skagon/HelioMax/FFCs/HelioMax.kicad_pcb

## KiCad design FFCs/HelioMax.kicad_pcb (2026-10-24)

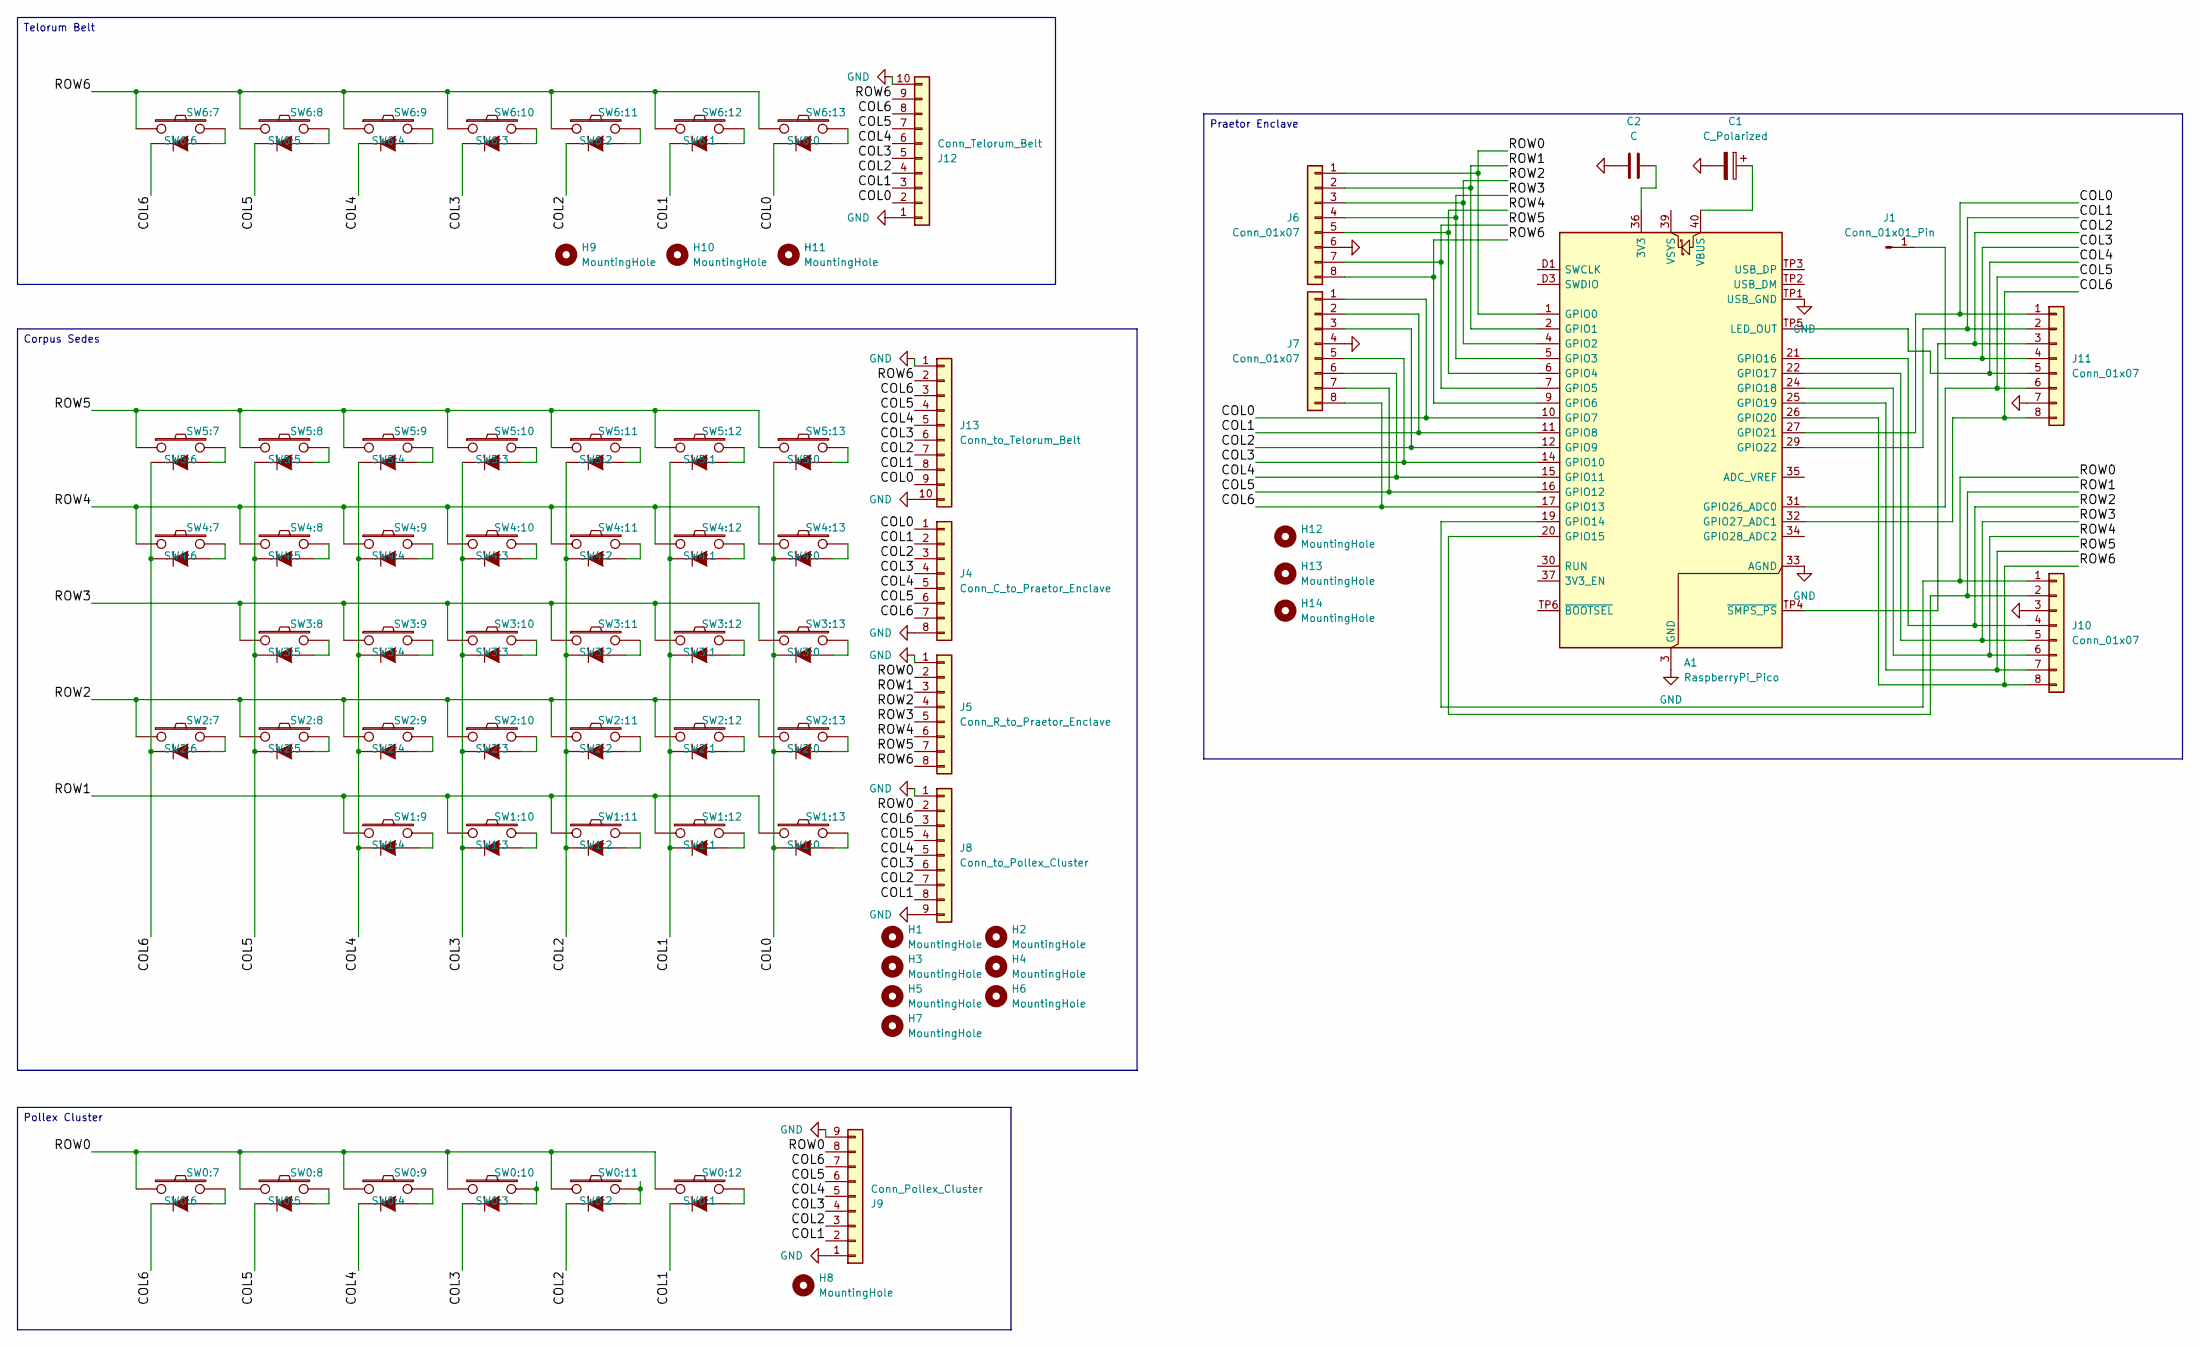
[picture p1: schematic HelioMax.kicad_sch]

Parts:
A1: RaspberryPi_Pico; RaspberryPi_Pico_Original_SMD_MountingHoles_HandSolder_Cast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
C1: C_Polarized; CP_Radial_D4.0mm_P2.00mm
C2: C; C_Rect_L7.0mm_W2.5mm_P5.00mm
H1, H2, H3, H4, H5, H6, H7, H8, H9, H10, H11, H12, H13, H14: MountingHole; MountingHole_3.2mm_M3
J1: Conn_01x01_Pin; PinHeader_1x01_P1.00mm_Vertical
J4: Conn_C_to_Praetor_Enclave; JST_SH_SM08B-SRSS-TB_1x08-1MP_P1.00mm_Horizontal
J5: Conn_R_to_Praetor_Enclave; JST_SH_SM08B-SRSS-TB_1x08-1MP_P1.00mm_Horizontal
J6, J7, J10, J11: Conn_01x07; JST_SH_SM08B-SRSS-TB_1x08-1MP_P1.00mm_Horizontal
J8: Conn_to_Pollex_Cluster; Molex_200528-0090_1x09-1MP_P1.00mm_Horizontal
J9: Conn_Pollex_Cluster; Molex_200528-0090_1x09-1MP_P1.00mm_Horizontal
J12: Conn_Telorum_Belt; Molex_200528-0100_1x10-1MP_P1.00mm_Horizontal
J13: Conn_to_Telorum_Belt; Molex_200528-0100_1x10-1MP_P1.00mm_Horizontal
SW0:7: SW0:6; MX_FLIP_CLEAN
SW0:8: SW0:5; MX_FLIP_CLEAN
SW0:9: SW0:4; MX_FLIP_CLEAN
SW0:10: SW0:3; MX_FLIP_CLEAN
SW0:11: SW0:2; MX_FLIP_CLEAN
SW0:12: SW0:1; MX_FLIP_CLEAN
SW1:9: SW1:4; MX_FLIP_CLEAN
SW1:10: SW1:3; MX_FLIP_CLEAN
SW1:11: SW1:2; MX_FLIP_CLEAN
SW1:12: SW1:1; MX_FLIP_CLEAN
SW1:13: SW1:0; MX_FLIP_CLEAN
SW2:7: SW2:6; MX_FLIP_CLEAN
SW2:8: SW2:5; MX_FLIP_CLEAN
SW2:9: SW2:4; MX_FLIP_CLEAN
SW2:10: SW2:3; MX_FLIP_CLEAN
SW2:11: SW2:2; MX_FLIP_CLEAN
SW2:12: SW2:1; MX_FLIP_CLEAN
SW2:13: SW2:0; MX_FLIP_CLEAN
SW3:8: SW3:5; MX_FLIP_CLEAN
SW3:9: SW3:4; MX_FLIP_CLEAN
SW3:10: SW3:3; MX_FLIP_CLEAN
SW3:11: SW3:2; MX_FLIP_CLEAN
SW3:12: SW3:1; MX_FLIP_CLEAN
SW3:13: SW3:0; MX_FLIP_CLEAN
SW4:7: SW4:6; MX_FLIP_CLEAN
SW4:8: SW4:5; MX_FLIP_CLEAN
SW4:9: SW4:4; MX_FLIP_CLEAN
SW4:10: SW4:3; MX_FLIP_CLEAN
SW4:11: SW4:2; MX_FLIP_CLEAN
SW4:12: SW4:1; MX_FLIP_CLEAN
SW4:13: SW4:0; MX_FLIP_CLEAN
SW5:7: SW5:6; MX_FLIP_CLEAN
SW5:8: SW5:5; MX_FLIP_CLEAN
SW5:9: SW5:4; MX_FLIP_CLEAN
SW5:10: SW5:3; MX_FLIP_CLEAN
SW5:11: SW5:2; MX_FLIP_CLEAN
SW5:12: SW5:1; MX_FLIP_CLEAN
SW5:13: SW5:0; MX_FLIP_CLEAN
SW6:7: SW6:6; MX_FLIP_CLEAN
SW6:8: SW6:5; MX_FLIP_CLEAN
SW6:9: SW6:4; MX_FLIP_CLEAN
SW6:10: SW6:3; MX_FLIP_CLEAN
SW6:11: SW6:2; MX_FLIP_CLEAN
SW6:12: SW6:1; MX_FLIP_CLEAN
SW6:13: SW6:0; MX_FLIP_CLEAN

Connections:
/COL0: A1.10 (GPIO7), A1.27 (GPIO21), J4.1, J7.1, J11.1, J12.2, J13.9, SW1:13.4 (K), SW2:13.4 (K), SW3:13.4 (K), SW4:13.4 (K), SW5:13.4 (K), SW6:13.4 (K); also elsewhere on the board
/COL1: A1.11 (GPIO8), A1.29 (GPIO22), J4.2, J7.2, J8.8, J9.2, J11.2, J12.3, J13.8, SW0:12.4 (K), SW1:12.4 (K), SW2:12.4 (K), SW3:12.4 (K), SW4:12.4 (K), SW5:12.4 (K), SW6:12.4 (K); also elsewhere on the board
/COL2: A1.12 (GPIO9), A1.TP4 (~SMPS_PS), J4.3, J7.3, J8.7, J9.3, J11.3, J12.4, J13.7, SW0:11.4 (K), SW1:11.4 (K), SW2:11.4 (K), SW3:11.4 (K), SW4:11.4 (K), SW5:11.4 (K), SW6:11.4 (K); also elsewhere on the board
/COL3: A1.14 (GPIO10), J1.1 (Pin_1_1), J4.4, J7.5, J8.6, J9.4, J11.4, J12.5, J13.6, SW0:10.4 (K), SW1:10.4 (K), SW2:10.4 (K), SW3:10.4 (K), SW4:10.4 (K), SW5:10.4 (K), SW6:10.4 (K); also elsewhere on the board
/COL4: A1.15 (GPIO11), A1.TP5 (LED_OUT), J4.5, J7.6, J8.5, J9.5, J11.5, J12.6, J13.5, SW0:9.4 (K), SW1:9.4 (K), SW2:9.4 (K), SW3:9.4 (K), SW4:9.4 (K), SW5:9.4 (K), SW6:9.4 (K); also elsewhere on the board
/COL5: A1.16 (GPIO12), A1.31 (GPIO26_ADC0), J4.6, J7.7, J8.4, J9.6, J11.6, J12.7, J13.4, SW0:8.4 (K), SW2:8.4 (K), SW3:8.4 (K), SW4:8.4 (K), SW5:8.4 (K), SW6:8.4 (K); also elsewhere on the board
/COL6: A1.17 (GPIO13), A1.32 (GPIO27_ADC1), J4.7, J7.8, J8.3, J9.7, J11.8, J12.8, J13.3, SW0:7.4 (K), SW2:7.4 (K), SW4:7.4 (K), SW5:7.4 (K), SW6:7.4 (K); also elsewhere on the board
/ROW0: A1.1 (GPIO0), A1.19 (GPIO14), J5.2, J6.1, J8.2, J9.8, J10.1, SW0:7.1, SW0:8.1, SW0:9.1, SW0:10.1, SW0:11.1, SW0:12.1; also elsewhere on the board
/ROW1: A1.2 (GPIO1), A1.20 (GPIO15), J5.3, J6.2, J10.2, SW1:9.1, SW1:10.1, SW1:11.1, SW1:12.1, SW1:13.1; also elsewhere on the board
/ROW2: A1.4 (GPIO2), A1.21 (GPIO16), J5.4, J6.3, J10.4, SW2:7.1, SW2:8.1, SW2:9.1, SW2:10.1, SW2:11.1, SW2:12.1, SW2:13.1; also elsewhere on the board
/ROW3: A1.5 (GPIO3), A1.22 (GPIO17), J5.5, J6.4, J10.5, SW3:8.1, SW3:9.1, SW3:10.1, SW3:11.1, SW3:12.1, SW3:13.1; also elsewhere on the board
/ROW4: A1.6 (GPIO4), A1.24 (GPIO18), J5.6, J6.5, J10.6, SW4:7.1, SW4:8.1, SW4:9.1, SW4:10.1, SW4:11.1, SW4:12.1, SW4:13.1; also elsewhere on the board
/ROW5: A1.7 (GPIO5), A1.25 (GPIO19), J5.7, J6.7, J10.7, SW5:7.1, SW5:8.1, SW5:9.1, SW5:10.1, SW5:11.1, SW5:12.1, SW5:13.1; also elsewhere on the board
/ROW6: A1.9 (GPIO6), A1.26 (GPIO20), J5.8, J6.8, J10.8, J12.9, J13.2, SW6:7.1, SW6:8.1, SW6:9.1, SW6:10.1, SW6:11.1, SW6:12.1, SW6:13.1; also elsewhere on the board
GND: A1.3 (GND), A1.8 (GND), A1.13 (GND), A1.18 (GND), A1.23 (GND), A1.28 (GND), A1.33 (AGND), A1.38 (GND), A1.D2 (GND), A1.TP1 (USB_GND), C1.2, C2.2, J4.8, J5.1, J6.6, J6.MP, J7.4, J7.MP, J8.1, J8.9, J8.MP, J9.1, J9.9, J9.MP, J10.3, J10.MP, J11.7, J11.MP, J12.1, J12.10, J12.MP, J13.1, J13.10, J13.MP; also elsewhere on the board
unnamed: A1.36 (3V3), C2.1
unnamed: A1.40 (VBUS), C1.1
unnamed: SW0:7.2, SW0:7.3 (A)
unnamed: SW0:8.2, SW0:8.3 (A)
unnamed: SW0:9.2, SW0:9.3 (A)
unnamed: SW0:10.2, SW0:10.3 (A)
unnamed: SW0:11.2, SW0:11.3 (A)
unnamed: SW0:12.2, SW0:12.3 (A)
unnamed: SW1:9.2, SW1:9.3 (A)
unnamed: SW1:10.2, SW1:10.3 (A)
unnamed: SW1:11.2, SW1:11.3 (A)
unnamed: SW1:12.2, SW1:12.3 (A)
unnamed: SW1:13.2, SW1:13.3 (A)
unnamed: SW2:7.2, SW2:7.3 (A)
unnamed: SW2:8.2, SW2:8.3 (A)
unnamed: SW2:9.2, SW2:9.3 (A)
unnamed: SW2:10.2, SW2:10.3 (A)
unnamed: SW2:11.2, SW2:11.3 (A)
unnamed: SW2:12.2, SW2:12.3 (A)
unnamed: SW2:13.2, SW2:13.3 (A)
unnamed: SW3:8.2, SW3:8.3 (A)
unnamed: SW3:9.2, SW3:9.3 (A)
unnamed: SW3:10.2, SW3:10.3 (A)
unnamed: SW3:11.2, SW3:11.3 (A)
unnamed: SW3:12.2, SW3:12.3 (A)
unnamed: SW3:13.2, SW3:13.3 (A)
unnamed: SW4:7.2, SW4:7.3 (A)
unnamed: SW4:8.2, SW4:8.3 (A)
unnamed: SW4:9.2, SW4:9.3 (A)
unnamed: SW4:10.2, SW4:10.3 (A)
unnamed: SW4:11.2, SW4:11.3 (A)
unnamed: SW4:12.2, SW4:12.3 (A)
unnamed: SW4:13.2, SW4:13.3 (A)
unnamed: SW5:7.2, SW5:7.3 (A)
unnamed: SW5:8.2, SW5:8.3 (A)
unnamed: SW5:9.2, SW5:9.3 (A)
unnamed: SW5:10.2, SW5:10.3 (A)
unnamed: SW5:11.2, SW5:11.3 (A)
unnamed: SW5:12.2, SW5:12.3 (A)
unnamed: SW5:13.2, SW5:13.3 (A)
unnamed: SW6:7.2, SW6:7.3 (A)
unnamed: SW6:8.2, SW6:8.3 (A)
unnamed: SW6:9.2, SW6:9.3 (A)
unnamed: SW6:10.2, SW6:10.3 (A)
unnamed: SW6:11.2, SW6:11.3 (A)
unnamed: SW6:12.2, SW6:12.3 (A)
unnamed: SW6:13.2, SW6:13.3 (A)

Notes on the sheet:
Telorum Belt
Pollex Cluster
Praetor Enclave
Corpus Sedes

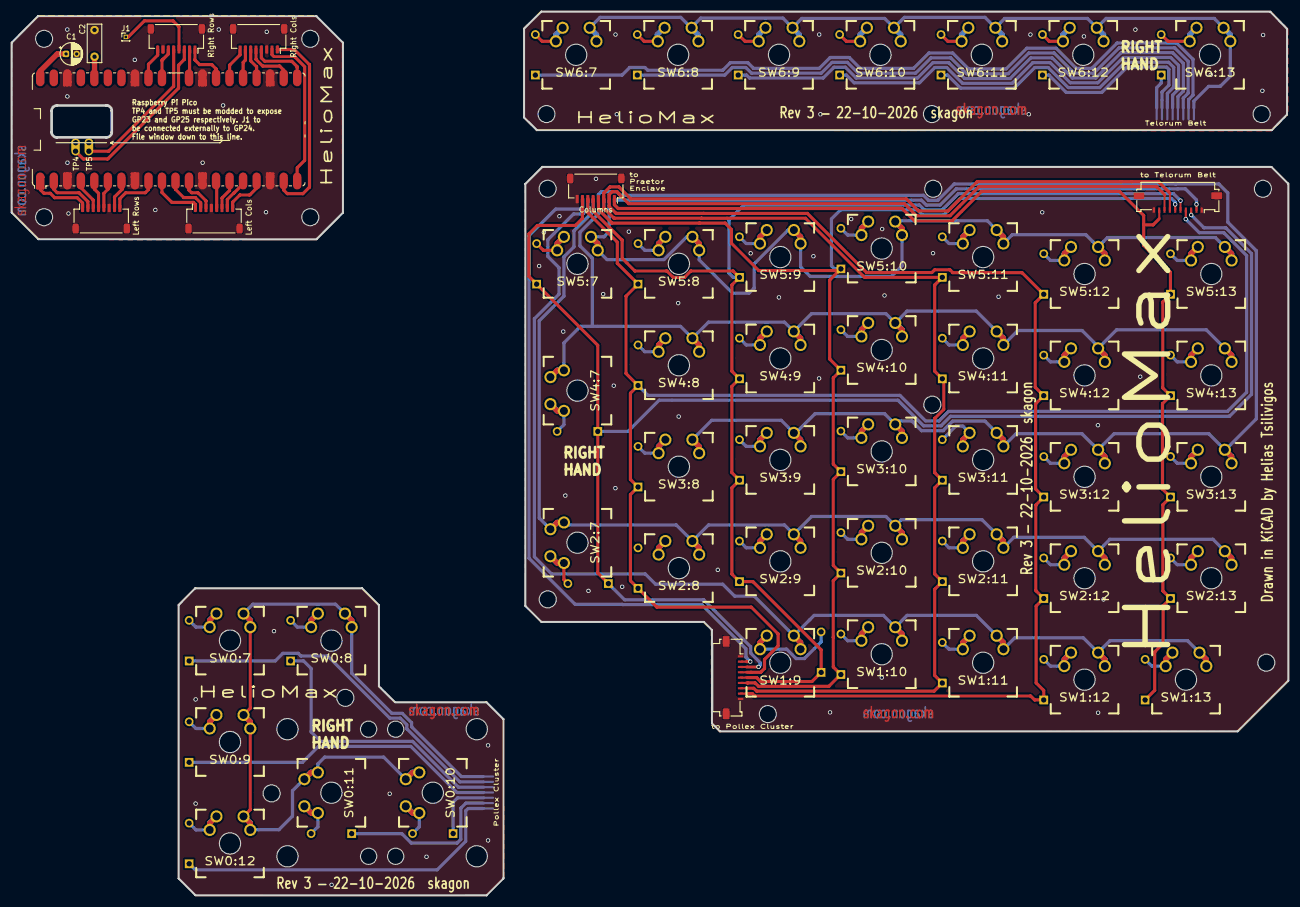
[picture p2: board HelioMax.kicad_pcb from above]

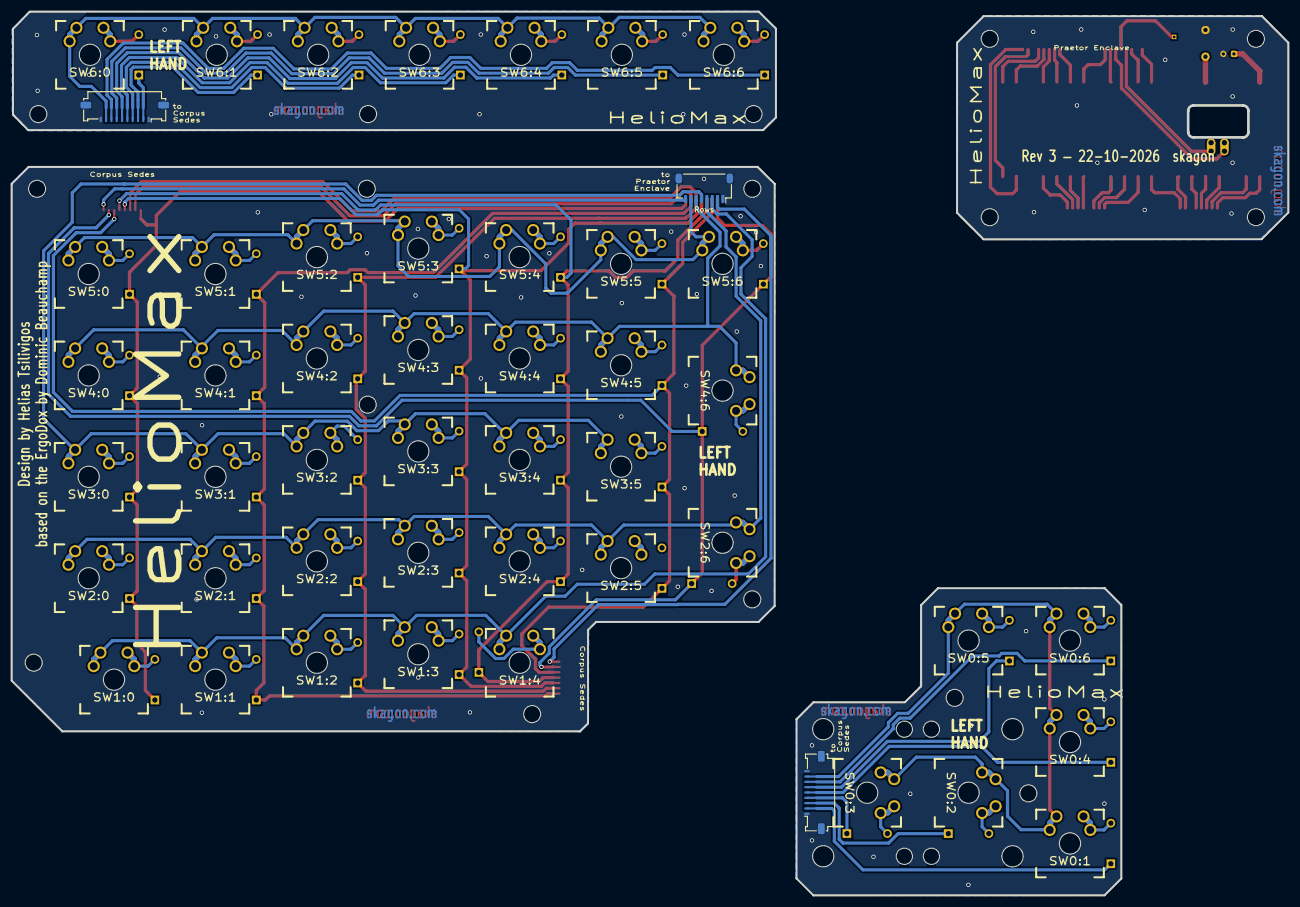
[picture p3: board HelioMax.kicad_pcb from below]

Board: 2 copper layers, 239.8 x 166.0 mm, 75 parts (3 on the bottom side), 62 nets.

Other parts of the board:
Columns: Conn_C_to_Praetor_Enclave; JST_SH_SM08B-SRSS-TB_1x08-1MP_P1.00mm_Horizontal
Rows: Conn_R_to_Praetor_Enclave; JST_SH_SM08B-SRSS-TB_1x08-1MP_P1.00mm_Horizontal
S1, S2: STAB200; STAB_PCB940

Their connections:
/COL0: Columns.1; also elsewhere on the board
/COL1: Columns.2; also elsewhere on the board
/COL2: Columns.3; also elsewhere on the board
/COL3: Columns.4; also elsewhere on the board
/COL4: Columns.5; also elsewhere on the board
/COL5: Columns.6; also elsewhere on the board
/COL6: Columns.7; also elsewhere on the board
/ROW0: Rows.2; also elsewhere on the board
/ROW1: Rows.3; also elsewhere on the board
/ROW2: Rows.4; also elsewhere on the board
/ROW3: Rows.5; also elsewhere on the board
/ROW4: Rows.6; also elsewhere on the board
/ROW5: Rows.7; also elsewhere on the board
/ROW6: Rows.8; also elsewhere on the board
GND: Columns.8, Columns.MP, Rows.1, Rows.MP; also elsewhere on the board
