skagon/HelioMax/FFCs/Corpus_Sedes/HelioMax_Corpus_Sedes.kicad_sch

## KiCad design FFCs/Corpus_Sedes/HelioMax_Corpus_Sedes.kicad_sch (2026-10-18)

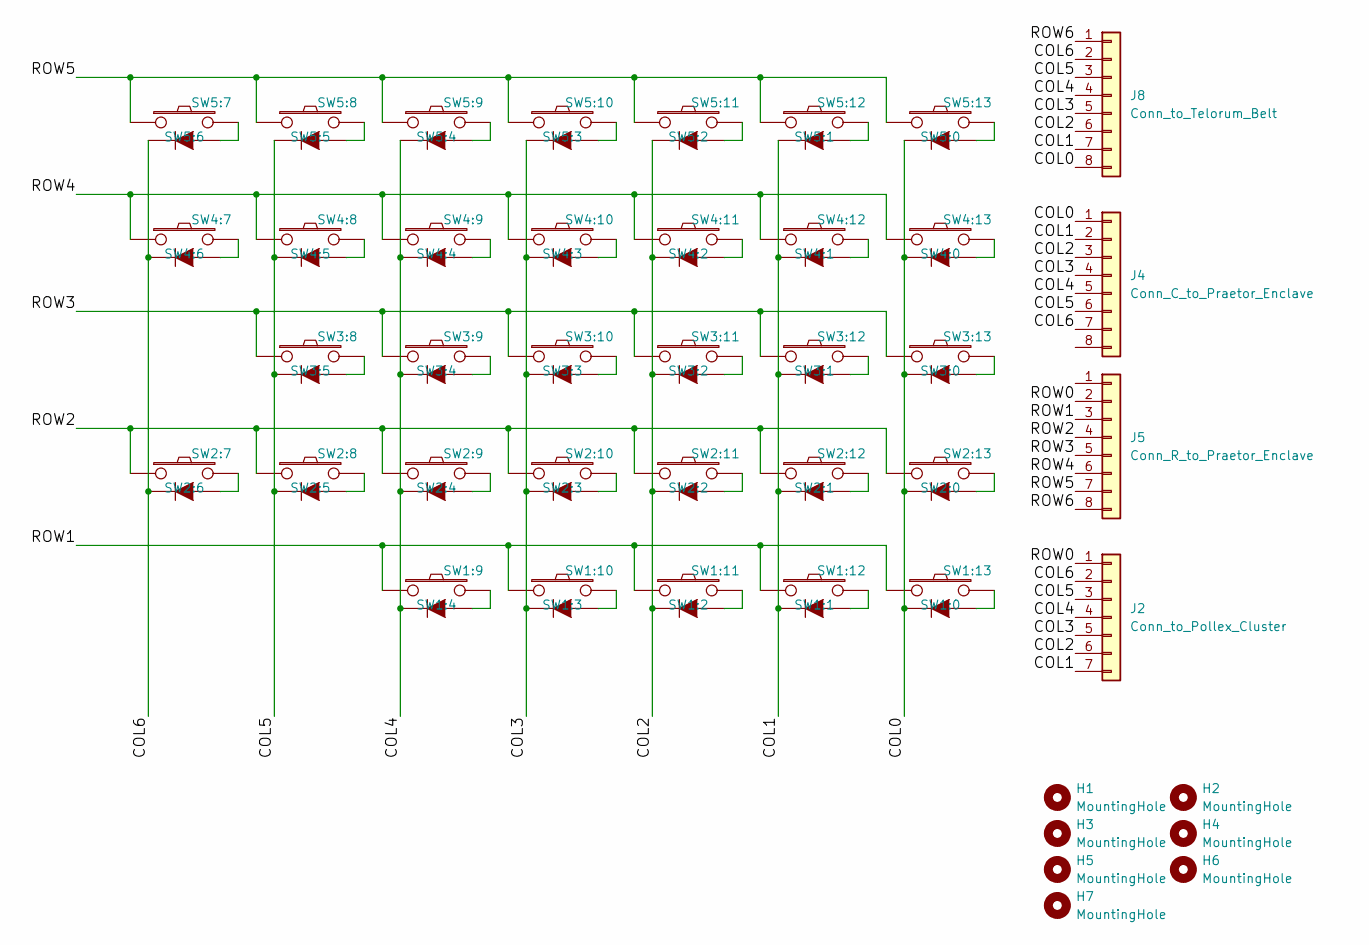
[picture p7: schematic HelioMax_Corpus_Sedes.kicad_sch]

Parts:
H1, H2, H3, H4, H5, H6, H7: MountingHole; MountingHole_3.2mm_M3
J2: Conn_to_Pollex_Cluster; PinHeader_1x07_P2.54mm_Vertical
J4: Conn_C_to_Praetor_Enclave; JST_SH_SM08B-SRSS-TB_1x08-1MP_P1.00mm_Horizontal
J5: Conn_R_to_Praetor_Enclave; JST_SH_SM08B-SRSS-TB_1x08-1MP_P1.00mm_Horizontal
J8: Conn_to_Telorum_Belt; PinHeader_1x08_P2.54mm_Vertical
SW1:9: SW1:4; MX_FLIP_CLEAN
SW1:10: SW1:3; MX_FLIP_CLEAN
SW1:11: SW1:2; MX_FLIP_CLEAN
SW1:12: SW1:1; MX_FLIP_CLEAN
SW1:13: SW1:0; MX_FLIP_CLEAN
SW2:7: SW2:6; MX_FLIP_CLEAN
SW2:8: SW2:5; MX_FLIP_CLEAN
SW2:9: SW2:4; MX_FLIP_CLEAN
SW2:10: SW2:3; MX_FLIP_CLEAN
SW2:11: SW2:2; MX_FLIP_CLEAN
SW2:12: SW2:1; MX_FLIP_CLEAN
SW2:13: SW2:0; MX_FLIP_CLEAN
SW3:8: SW3:5; MX_FLIP_CLEAN
SW3:9: SW3:4; MX_FLIP_CLEAN
SW3:10: SW3:3; MX_FLIP_CLEAN
SW3:11: SW3:2; MX_FLIP_CLEAN
SW3:12: SW3:1; MX_FLIP_CLEAN
SW3:13: SW3:0; MX_FLIP_CLEAN
SW4:7: SW4:6; MX_FLIP_CLEAN
SW4:8: SW4:5; MX_FLIP_CLEAN
SW4:9: SW4:4; MX_FLIP_CLEAN
SW4:10: SW4:3; MX_FLIP_CLEAN
SW4:11: SW4:2; MX_FLIP_CLEAN
SW4:12: SW4:1; MX_FLIP_CLEAN
SW4:13: SW4:0; MX_FLIP_CLEAN
SW5:7: SW5:6; MX_FLIP_CLEAN
SW5:8: SW5:5; MX_FLIP_CLEAN
SW5:9: SW5:4; MX_FLIP_CLEAN
SW5:10: SW5:3; MX_FLIP_CLEAN
SW5:11: SW5:2; MX_FLIP_CLEAN
SW5:12: SW5:1; MX_FLIP_CLEAN
SW5:13: SW5:0; MX_FLIP_CLEAN

Connections:
COL0: J4.1, J8.8, SW1:13.4 (K), SW2:13.4 (K), SW3:13.4 (K), SW4:13.4 (K), SW5:13.4 (K)
COL1: J2.7, J4.2, J8.7, SW1:12.4 (K), SW2:12.4 (K), SW3:12.4 (K), SW4:12.4 (K), SW5:12.4 (K)
COL2: J2.6, J4.3, J8.6, SW1:11.4 (K), SW2:11.4 (K), SW3:11.4 (K), SW4:11.4 (K), SW5:11.4 (K)
COL3: J2.5, J4.4, J8.5, SW1:10.4 (K), SW2:10.4 (K), SW3:10.4 (K), SW4:10.4 (K), SW5:10.4 (K)
COL4: J2.4, J4.5, J8.4, SW1:9.4 (K), SW2:9.4 (K), SW3:9.4 (K), SW4:9.4 (K), SW5:9.4 (K)
COL5: J2.3, J4.6, J8.3, SW2:8.4 (K), SW3:8.4 (K), SW4:8.4 (K), SW5:8.4 (K)
COL6: J2.2, J4.7, J8.2, SW2:7.4 (K), SW4:7.4 (K), SW5:7.4 (K)
unnamed: SW1:9.2, SW1:9.3 (A)
unnamed: SW1:10.2, SW1:10.3 (A)
unnamed: SW1:11.2, SW1:11.3 (A)
unnamed: SW1:12.2, SW1:12.3 (A)
unnamed: SW1:13.2, SW1:13.3 (A)
unnamed: SW2:7.2, SW2:7.3 (A)
unnamed: SW2:8.2, SW2:8.3 (A)
unnamed: SW2:9.2, SW2:9.3 (A)
unnamed: SW2:10.2, SW2:10.3 (A)
unnamed: SW2:11.2, SW2:11.3 (A)
unnamed: SW2:12.2, SW2:12.3 (A)
unnamed: SW2:13.2, SW2:13.3 (A)
unnamed: SW3:8.2, SW3:8.3 (A)
unnamed: SW3:9.2, SW3:9.3 (A)
unnamed: SW3:10.2, SW3:10.3 (A)
unnamed: SW3:11.2, SW3:11.3 (A)
unnamed: SW3:12.2, SW3:12.3 (A)
unnamed: SW3:13.2, SW3:13.3 (A)
unnamed: SW4:7.2, SW4:7.3 (A)
unnamed: SW4:8.2, SW4:8.3 (A)
unnamed: SW4:9.2, SW4:9.3 (A)
unnamed: SW4:10.2, SW4:10.3 (A)
unnamed: SW4:11.2, SW4:11.3 (A)
unnamed: SW4:12.2, SW4:12.3 (A)
unnamed: SW4:13.2, SW4:13.3 (A)
unnamed: SW5:7.2, SW5:7.3 (A)
unnamed: SW5:8.2, SW5:8.3 (A)
unnamed: SW5:9.2, SW5:9.3 (A)
unnamed: SW5:10.2, SW5:10.3 (A)
unnamed: SW5:11.2, SW5:11.3 (A)
unnamed: SW5:12.2, SW5:12.3 (A)
unnamed: SW5:13.2, SW5:13.3 (A)
ROW0: J2.1, J5.2
ROW1: J5.3, SW1:9.1, SW1:10.1, SW1:11.1, SW1:12.1, SW1:13.1
ROW2: J5.4, SW2:7.1, SW2:8.1, SW2:9.1, SW2:10.1, SW2:11.1, SW2:12.1, SW2:13.1
ROW3: J5.5, SW3:8.1, SW3:9.1, SW3:10.1, SW3:11.1, SW3:12.1, SW3:13.1
ROW4: J5.6, SW4:7.1, SW4:8.1, SW4:9.1, SW4:10.1, SW4:11.1, SW4:12.1, SW4:13.1
ROW5: J5.7, SW5:7.1, SW5:8.1, SW5:9.1, SW5:10.1, SW5:11.1, SW5:12.1, SW5:13.1
ROW6: J5.8, J8.1
