skagon/HelioMax/FFCs/Pollex_Cluster/HelioMax_Pollex_Cluster.kicad_sch

## KiCad design FFCs/Pollex_Cluster/HelioMax_Pollex_Cluster.kicad_sch (2026-10-18)

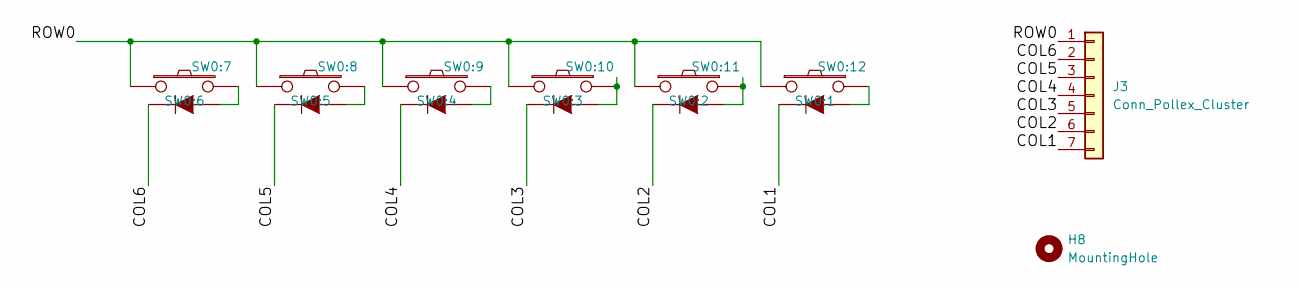
[picture p8: schematic HelioMax_Pollex_Cluster.kicad_sch]

Parts:
H8: MountingHole; MountingHole_3.2mm_M3
J3: Conn_Pollex_Cluster; PinHeader_1x07_P2.54mm_Vertical
SW0:7: SW0:6; MX_FLIP_CLEAN
SW0:8: SW0:5; MX_FLIP_CLEAN
SW0:9: SW0:4; MX_FLIP_CLEAN
SW0:10: SW0:3; MX_FLIP_CLEAN
SW0:11: SW0:2; MX_FLIP_CLEAN
SW0:12: SW0:1; MX_FLIP_CLEAN

Connections:
COL1: J3.7, SW0:12.4 (K)
COL2: J3.6, SW0:11.4 (K)
COL3: J3.5, SW0:10.4 (K)
COL4: J3.4, SW0:9.4 (K)
COL5: J3.3, SW0:8.4 (K)
COL6: J3.2, SW0:7.4 (K)
unnamed: SW0:7.2, SW0:7.3 (A)
unnamed: SW0:8.2, SW0:8.3 (A)
unnamed: SW0:9.2, SW0:9.3 (A)
unnamed: SW0:10.2, SW0:10.3 (A)
unnamed: SW0:11.2, SW0:11.3 (A)
unnamed: SW0:12.2, SW0:12.3 (A)
ROW0: J3.1, SW0:7.1, SW0:8.1, SW0:9.1, SW0:10.1, SW0:11.1, SW0:12.1
