skagon/HelioMax/FFCs/Praetor_Enclave/HelioMax_Praetor_Enclave.kicad_sch

## KiCad design FFCs/Praetor_Enclave/HelioMax_Praetor_Enclave.kicad_sch (2026-10-18)


Parts:
A1: RaspberryPi_Pico; RaspberryPi_Pico_Original_SMD_MountingHoles_HandSolder_Cast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
H12, H13, H14: MountingHole; MountingHole_3.2mm_M3
J1: Conn_01x01_Pin; PinHeader_1x01_P1.00mm_Vertical
J6, J7, J10, J11: Conn_01x07; JST_SH_SM08B-SRSS-TB_1x08-1MP_P1.00mm_Horizontal

Connections:
GND: A1.3 (GND), A1.8 (GND), A1.13 (GND), A1.18 (GND), A1.23 (GND), A1.28 (GND), A1.33 (AGND), A1.38 (GND), A1.D2 (GND), A1.TP1 (USB_GND)
unnamed: A1.1 (GPIO0), J6.1
unnamed: A1.2 (GPIO1), J6.2
unnamed: A1.4 (GPIO2), J6.3
unnamed: A1.5 (GPIO3), J6.4
unnamed: A1.6 (GPIO4), J6.5
unnamed: A1.7 (GPIO5), J6.7
unnamed: A1.9 (GPIO6), J6.8
unnamed: A1.10 (GPIO7), J7.1
unnamed: A1.11 (GPIO8), J7.2
unnamed: A1.12 (GPIO9), J7.3
unnamed: A1.14 (GPIO10), J7.5
unnamed: A1.15 (GPIO11), J7.6
unnamed: A1.16 (GPIO12), J7.7
unnamed: A1.17 (GPIO13), J7.8
unnamed: A1.19 (GPIO14), J10.1
unnamed: A1.20 (GPIO15), J10.2
unnamed: A1.21 (GPIO16), J10.4
unnamed: A1.22 (GPIO17), J10.5
unnamed: A1.24 (GPIO18), J10.6
unnamed: A1.25 (GPIO19), J10.7
unnamed: A1.26 (GPIO20), J10.8
unnamed: A1.27 (GPIO21), J11.1
unnamed: A1.29 (GPIO22), J11.2
unnamed: A1.31 (GPIO26_ADC0), J11.6
unnamed: A1.32 (GPIO27_ADC1), J11.8
unnamed: A1.TP4 (~SMPS_PS), J11.3
unnamed: A1.TP5 (LED_OUT), J11.5
unnamed: J1.1, J11.4
