skagon/HelioMax/FFCs/Telorum_Belt/HelioMax_Telorum_Belt.kicad_sch

## KiCad design FFCs/Telorum_Belt/HelioMax_Telorum_Belt.kicad_sch (2026-10-18)

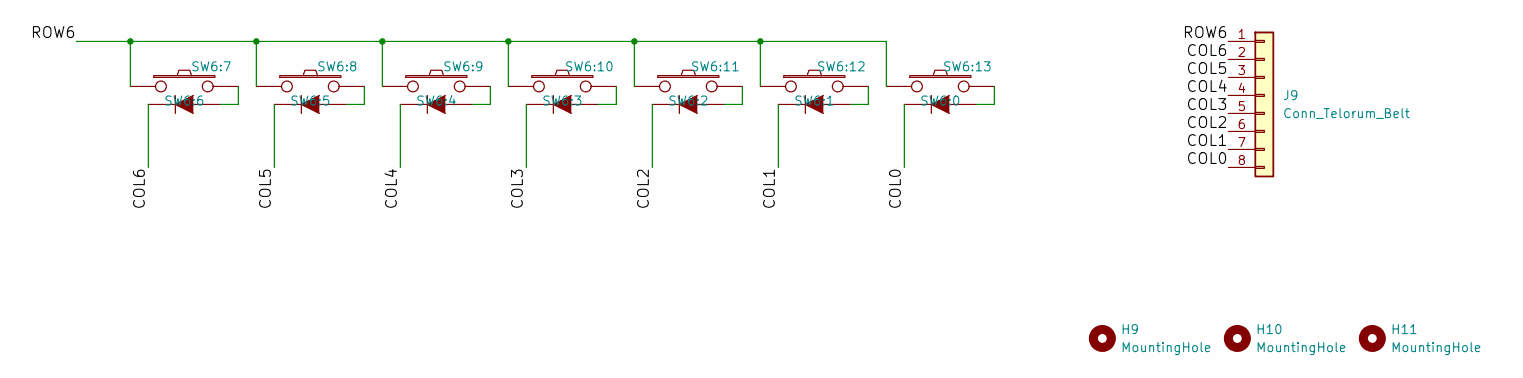
[picture p9: schematic HelioMax_Telorum_Belt.kicad_sch]

Parts:
H9, H10, H11: MountingHole; MountingHole_3.2mm_M3
J9: Conn_Telorum_Belt; PinHeader_1x08_P2.54mm_Vertical
SW6:7: SW6:6; MX_FLIP_CLEAN
SW6:8: SW6:5; MX_FLIP_CLEAN
SW6:9: SW6:4; MX_FLIP_CLEAN
SW6:10: SW6:3; MX_FLIP_CLEAN
SW6:11: SW6:2; MX_FLIP_CLEAN
SW6:12: SW6:1; MX_FLIP_CLEAN
SW6:13: SW6:0; MX_FLIP_CLEAN

Connections:
COL0: J9.8, SW6:13.4 (K)
COL1: J9.7, SW6:12.4 (K)
COL2: J9.6, SW6:11.4 (K)
COL3: J9.5, SW6:10.4 (K)
COL4: J9.4, SW6:9.4 (K)
COL5: J9.3, SW6:8.4 (K)
COL6: J9.2, SW6:7.4 (K)
unnamed: SW6:7.2, SW6:7.3 (A)
unnamed: SW6:8.2, SW6:8.3 (A)
unnamed: SW6:9.2, SW6:9.3 (A)
unnamed: SW6:10.2, SW6:10.3 (A)
unnamed: SW6:11.2, SW6:11.3 (A)
unnamed: SW6:12.2, SW6:12.3 (A)
unnamed: SW6:13.2, SW6:13.3 (A)
ROW6: J9.1, SW6:7.1, SW6:8.1, SW6:9.1, SW6:10.1, SW6:11.1, SW6:12.1, SW6:13.1
