skagon/HelioMax/(commit log)

2026-10-14 Initial commit for the HelioMax project files.
    [ErgoDOX-2023-04-19-11-33-54.sch, ErgoDOX-2026-09-25-16-19-44.sch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]
2026-10-15 Fixed edge cuts. Lots of DRC errors.
    [HelioMax.kicad_pcb, HelioMax.kicad_sch]
2026-10-16 Updated switch footprint and fixed all wiring.
    [HelioMax.kicad_pcb, HelioMax.kicad_sch]
2026-10-16 Fixed most DRC problems, new vias, modified switch footprints.
    [HelioMax.kicad_pcb]
2026-10-17 Replace relic holes, include fonts, general clean-up and rewiring.
    [HelioMax.kicad_pcb, HelioMax.kicad_sch]
2026-10-17 Clean-up, final DRC issues resolved, minor rewiring.
    [HelioMax-B.Mask.gbs, HelioMax-B.Paste.gbp, HelioMax-B.SilkS.gbo, HelioMax-B_Mask.gbs, HelioMax-B_Paste.gbp, HelioMax-B_Silkscreen.gbo, HelioMax-Back.gbl, HelioMax-Cmts.User.gbr]
2026-10-18 Broke project into four distinct projects, one for each PCB
    [HelioMax_Corpus_Sedes.kicad_pcb, HelioMax_Corpus_Sedes.kicad_sch, HelioMax_Pollex_Cluster.kicad_pcb, HelioMax_Pollex_Cluster.kicad_sch, HelioMax_Praetor_Enclave.kicad_pcb, HelioMax_Praetor_Enclave.kicad_sch, HelioMax_Telorum_Belt.kicad_pcb, HelioMax_Telorum_Belt.kicad_sch]
2026-10-18 Wrote README.md (and some minor wiring changes)
2026-10-18 Added donations (as if anybody will do that)
    [HelioMax-B_Mask.gbs, HelioMax-B_Paste.gbp, HelioMax-B_Silkscreen.gbo, HelioMax-Back.gbl, HelioMax-Edge_Cuts.gm1, HelioMax-F_Mask.gts, HelioMax-F_Paste.gtp, HelioMax-F_Silkscreen.gto]
2026-10-19 Massive update: New switch footprint with side diode, all boards rewired.
    [HelioMax.kicad_pcb]
2026-10-19 Minor wiring corrections.
    [HelioMax.kicad_pcb]
2026-10-19 More minor wiring corrections.
    [HelioMax.kicad_pcb]
2026-10-19 Big clean-up, pseudo-castellations, optimised Pico wiring, silkscreen adjustments, thumb cluster fixes.
    [HelioMax.kicad_pcb]
2026-10-21 Restructuring to accommodate Pins in new directory
    [ErgoDOX-2023-04-19-11-33-54.sch, ErgoDOX-2026-09-25-16-19-44.sch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]
2026-10-21 Independent FFC and Pins dirs
    [HelioMax-B_Mask.gbs, HelioMax-B_Paste.gbp, HelioMax-B_Silkscreen.gbo, HelioMax-Back.gbl, HelioMax-Edge_Cuts.gm1, HelioMax-F_Mask.gts, HelioMax-F_Paste.gtp, HelioMax-F_Silkscreen.gto]
2026-10-21 Minor wiring changes
    [HelioMax.kicad_pcb]
2026-10-21 Eliminated two vias in Pollex Cluster. Some minor wiring cleanup.
    [HelioMax.kicad_pcb]
2026-10-22 added caps and ground planes. Fixed stuff.
    [HelioMax.kicad_pcb, HelioMax.kicad_sch]
2026-10-22 Fixed FFC connector, grounded the MPs.
    [HelioMax-B_Mask.gbs, HelioMax-B_Paste.gbp, HelioMax-B_Silkscreen.gbo, HelioMax-Back.gbl, HelioMax-Edge_Cuts.gm1, HelioMax-F_Mask.gts, HelioMax-F_Paste.gtp, HelioMax-F_Silkscreen.gto]
2026-10-24 Fixed labels and glyphs. Found more problems (perhaps).
    [HelioMax.kicad_pcb]
